westonb/wbraun_kicad_library/3D_Models/Transformer_POE13P.step

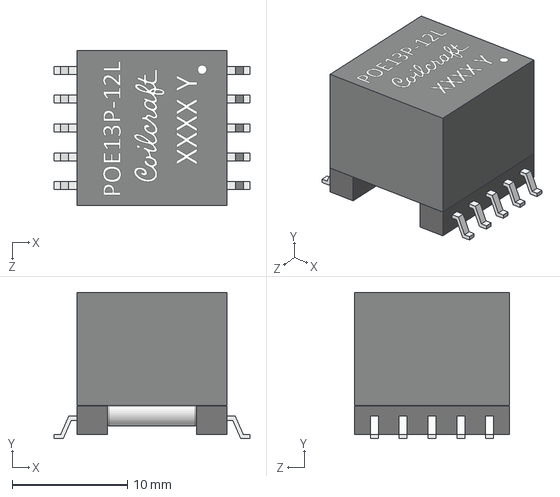
[picture p1: CAD file, 2026-11-03]
3D_Models/Transformer_POE13P.step
17.0 x 12.7 x 13.5 mm
