westonb/wbraun_kicad_library/3D_Models/C_Trimmer_GKG_6mm.step

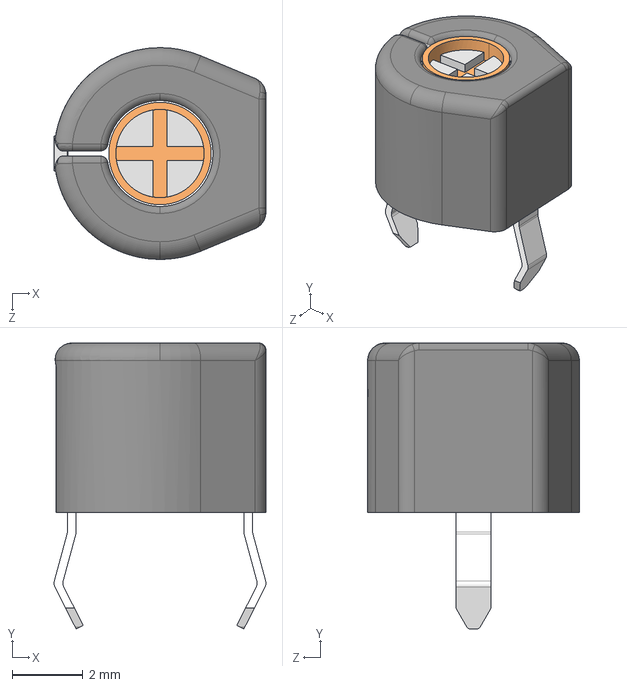
[picture p2: CAD file, 2026-11-03]
3D_Models/C_Trimmer_GKG_6mm.step
6.00 x 8.10 x 6.00 mm
