westonb/wbraun_kicad_library/3D_Models/SW_DPDT_x2_ALPS_SPUJ190900.stp

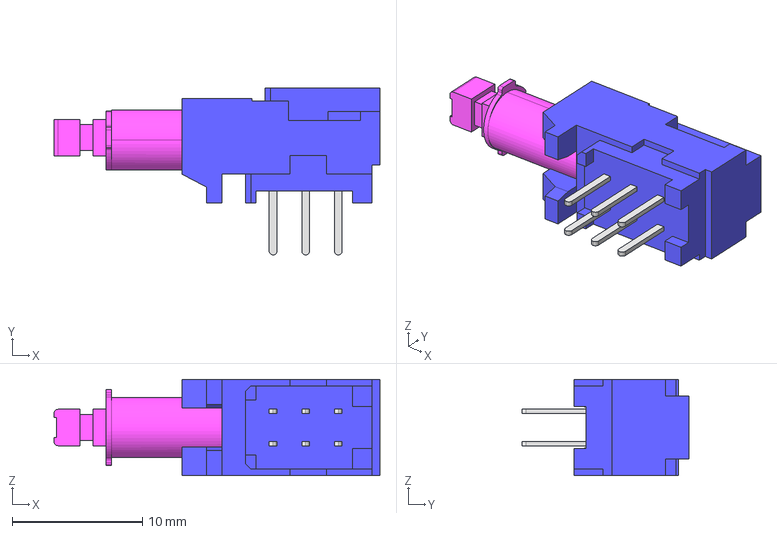
[picture p3: CAD file, 2026-11-03]
3D_Models/SW_DPDT_x2_ALPS_SPUJ190900.stp
25.0 x 12.8 x 7.40 mm
