westonb/wbraun_kicad_library/3D_Models/Converter_DCDC_1W_Isolated_Short.step

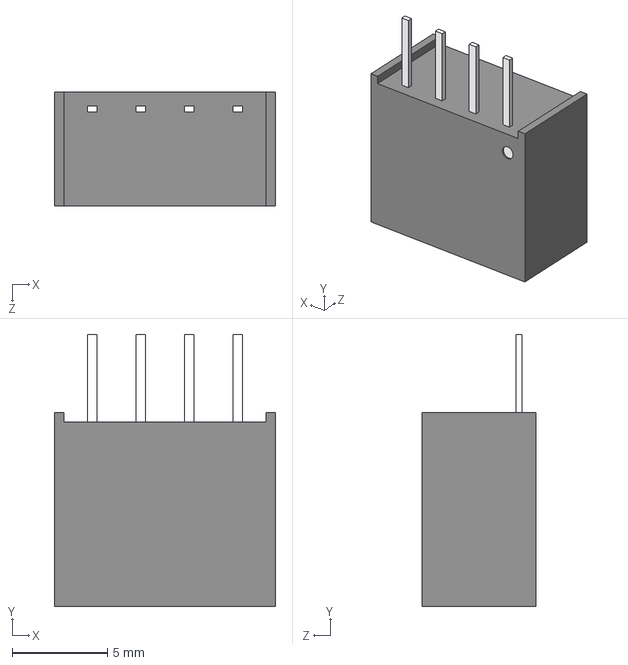
[picture p4: CAD file, 2026-11-03]
3D_Models/Converter_DCDC_1W_Isolated_Short.step
11.6 x 14.3 x 6.00 mm
