westonb/wbraun_kicad_library/3D_Models/EQ25-core.stp

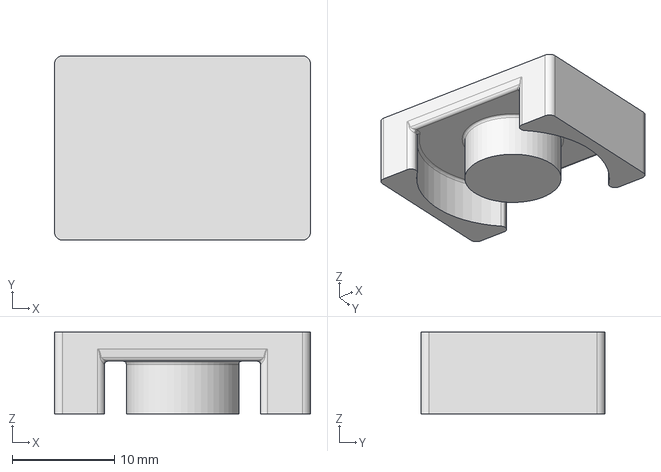
[picture p5: CAD file, 2026-11-03]
3D_Models/EQ25-core.stp
25.0 x 18.0 x 8.00 mm
