westonb/wbraun_kicad_library/3D_Models/SW_DIP_x04_CUI_DS02C-254-1L-04BE.step

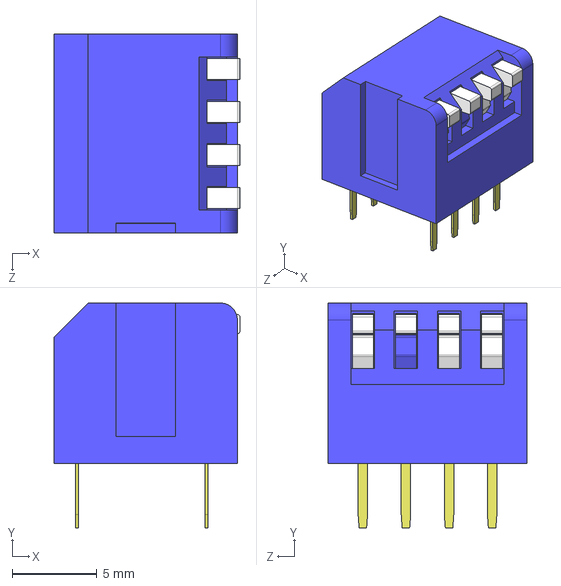
[picture p6: CAD file, 2026-11-03]
3D_Models/SW_DIP_x04_CUI_DS02C-254-1L-04BE.step
11.0 x 13.3 x 11.7 mm
