westonb/wbraun_kicad_library/3D_Models/TO-270WB-4.STEP

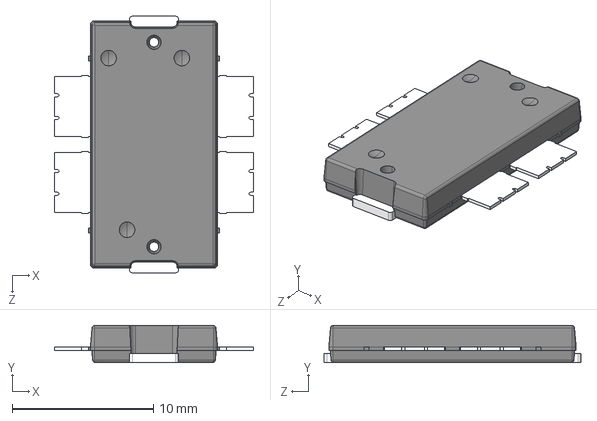
[picture p7: CAD file, 2026-11-03]
3D_Models/TO-270WB-4.STEP
14.1 x 2.64 x 18.2 mm
