westonb/wbraun_kicad_library/3D_Models/L_CommonModeChoke_Murata_DLW5BTM.STEP

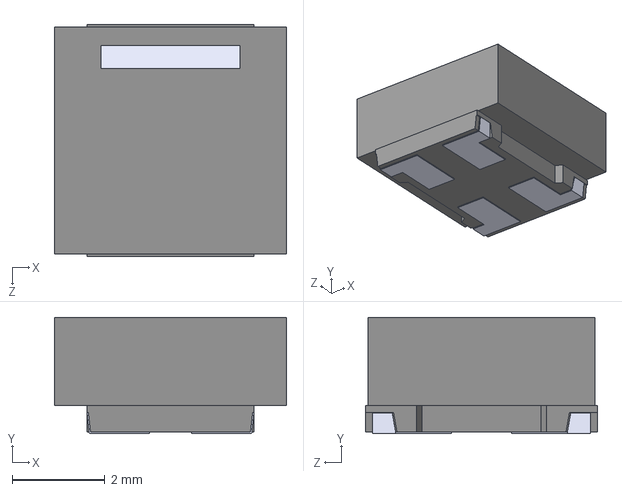
[picture p8: CAD file, 2022-10-10]
3D_Models/L_CommonModeChoke_Murata_DLW5BTM.STEP
5.00 x 2.50 x 5.00 mm
