westonb/wbraun_kicad_library/3D_Models/Coilcraft-1812SMS-27N.STEP

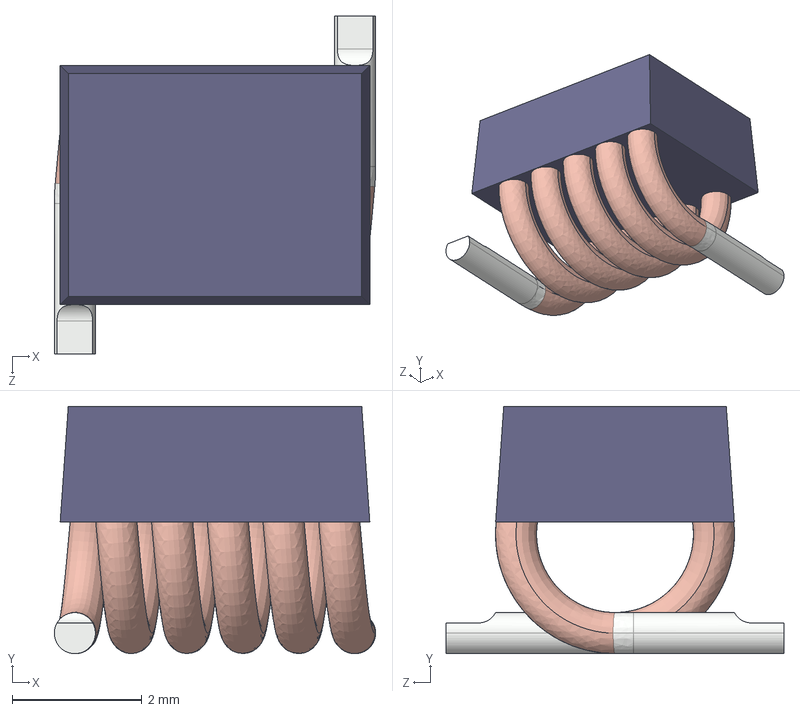
[picture p9: CAD file, 2022-10-10]
3D_Models/Coilcraft-1812SMS-27N.STEP
4.95 x 3.81 x 5.21 mm
Coilcraft-1812SMS-27N_W XXATZ2-X [1812SMS]_1812SMS-27N_2
Coilcraft-1812SMS-27N_36-625 [T7-566-1]_1812SMS-XXXL_2
