westonb/wbraun_kicad_library/3D_Models/GDT_1812.stp

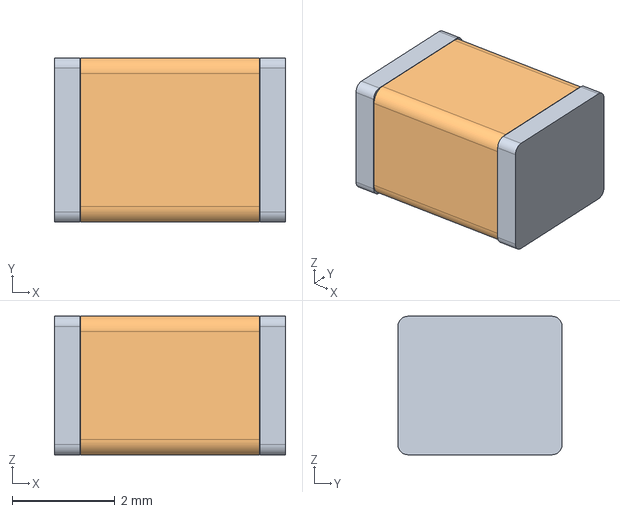
[picture p10: CAD file, 2022-10-10]
3D_Models/GDT_1812.stp
4.50 x 3.20 x 2.70 mm
