westonb/wbraun_kicad_library/3D_Models/LED-T1-RIGHT-ANGLE.STEP

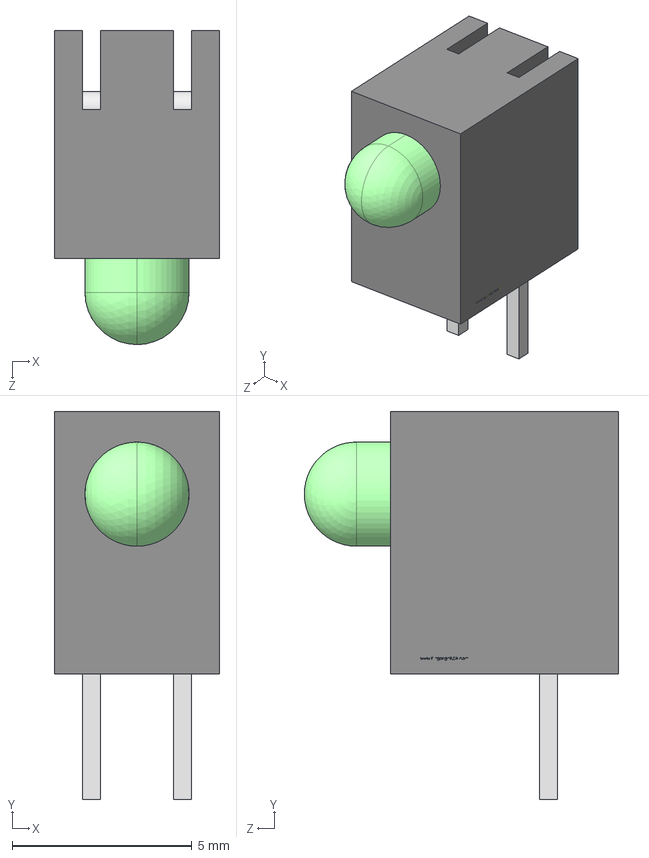
[picture p11: CAD file, 2022-10-10]
3D_Models/LED-T1-RIGHT-ANGLE.STEP
4.60 x 10.8 x 8.75 mm
