westonb/wbraun_kicad_library/3D_Models/Masach_Tech_MS288-10F.step

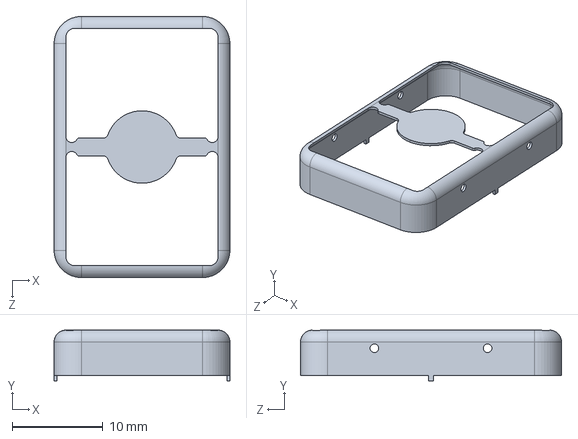
[picture p12: CAD file, 2022-10-10]
3D_Models/Masach_Tech_MS288-10F.step
19.4 x 5.60 x 28.8 mm
