westonb/wbraun_kicad_library/3D_Models/LED_WP934MD.STEP

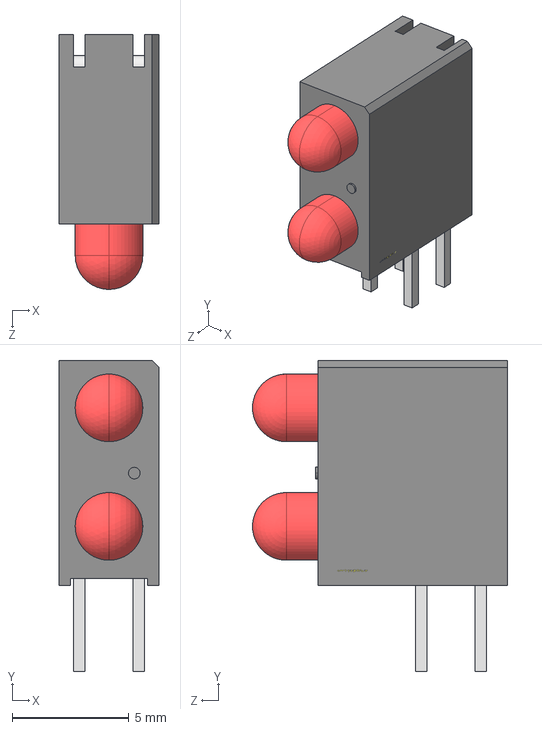
[picture p13: CAD file, 2022-10-10]
3D_Models/LED_WP934MD.STEP
4.30 x 13.3 x 10.9 mm
