westonb/wbraun_kicad_library/3D_Models/SMA_Molex_73251-2200.stp

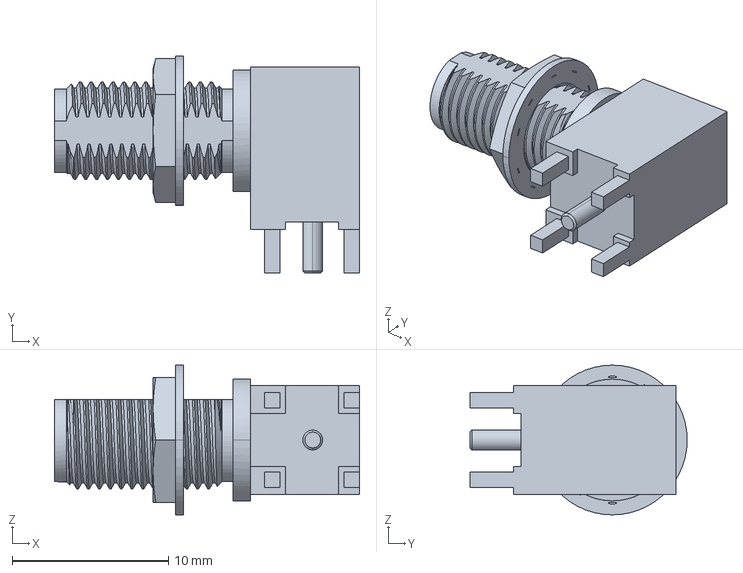
[picture p14: CAD file, 2022-10-10]
3D_Models/SMA_Molex_73251-2200.stp
19.5 x 13.9 x 9.60 mm
