westonb/wbraun_kicad_library/3D_Models/mill-max-0906-1-15-20-75-14-11-0.step

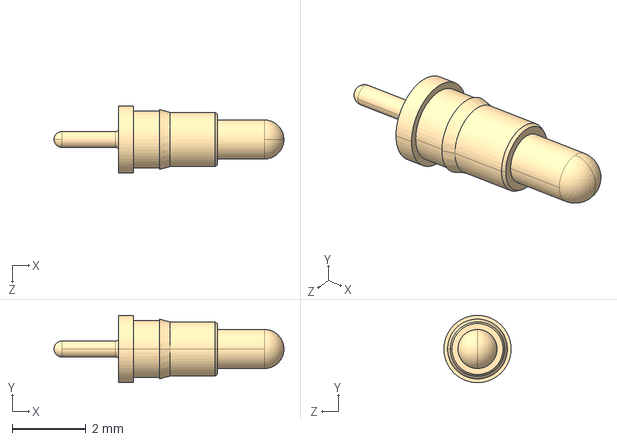
[picture p15: CAD file, 2022-10-10]
3D_Models/mill-max-0906-1-15-20-75-14-11-0.step
6.25 x 1.83 x 1.83 mm
