westonb/wbraun_kicad_library/3D_Models/D_POWERDI323.step

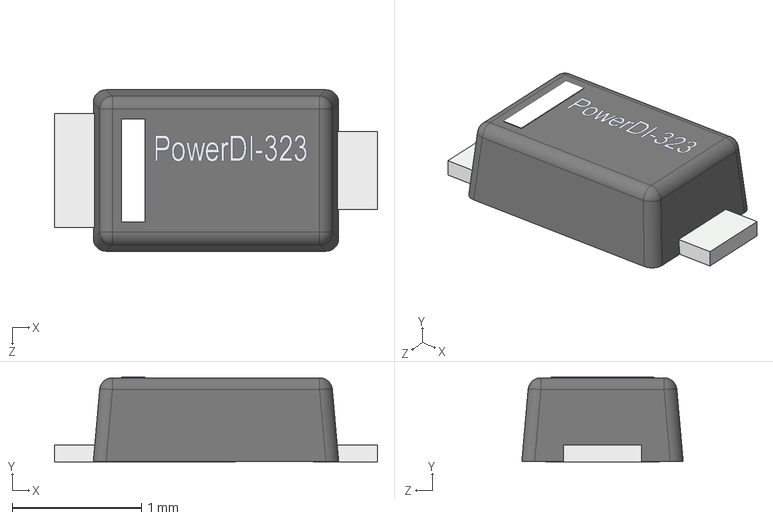
[picture p16: CAD file, 2022-10-10]
3D_Models/D_POWERDI323.step
2.50 x 0.656 x 1.25 mm
