westonb/wbraun_kicad_library/3D_Models/USB_B_OST_USB-B1HSxx_Horizontal.STEP

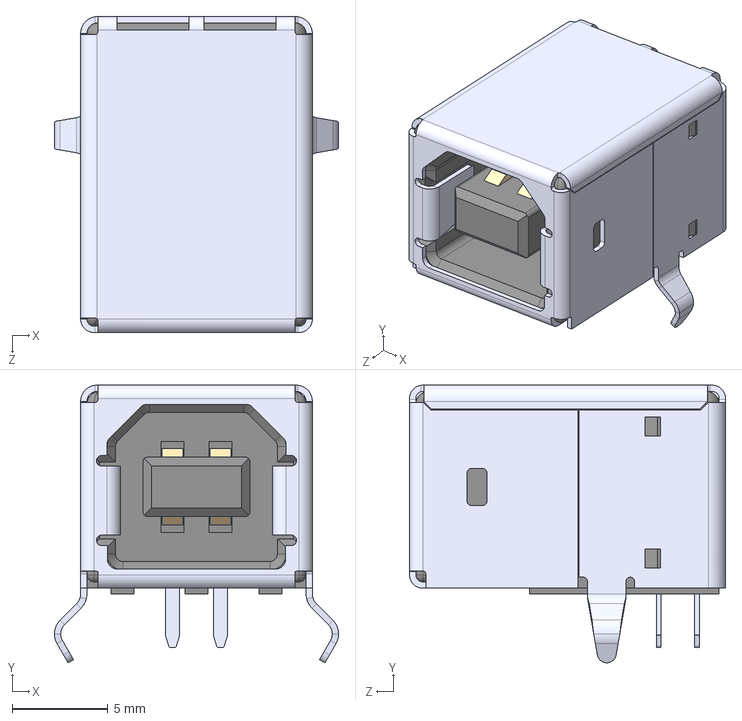
[picture p17: CAD file, 2022-10-10]
3D_Models/USB_B_OST_USB-B1HSxx_Horizontal.STEP
14.8 x 14.5 x 16.5 mm
