westonb/wbraun_kicad_library/3D_Models/CUI_DEVICES_DS01C-254-S-08BE.step

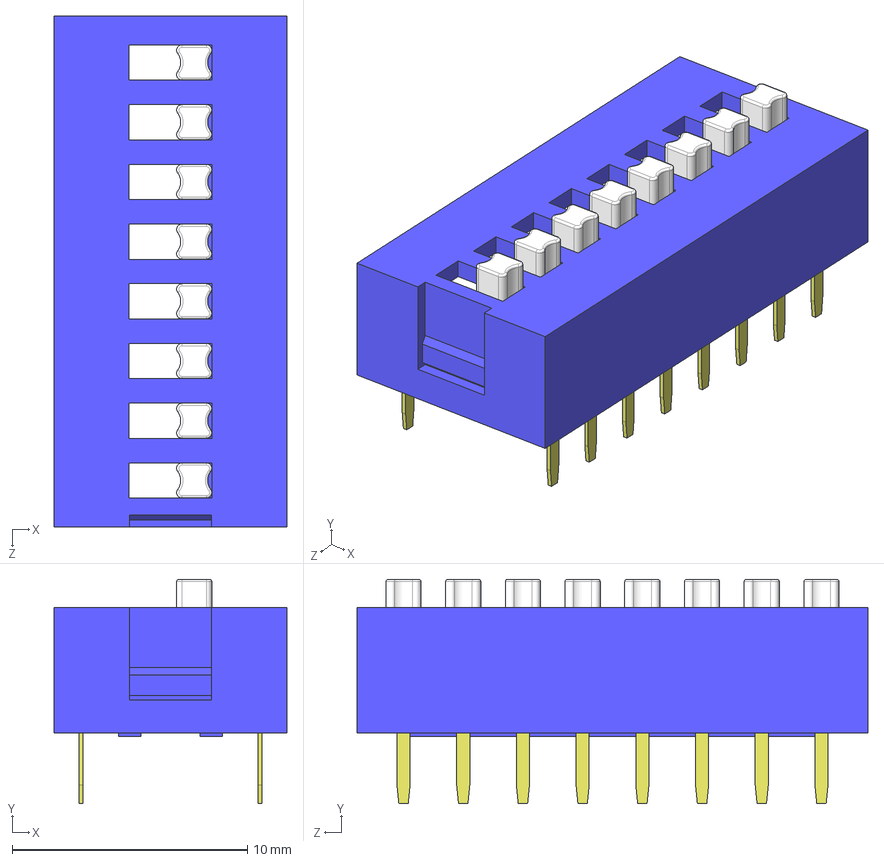
[picture p18: CAD file, 2021-12-18]
3D_Models/CUI_DEVICES_DS01C-254-S-08BE.step
9.90 x 9.55 x 21.7 mm
