westonb/wbraun_kicad_library/3D_Models/PTS810 SJK 250 SMTR LFS--3DModel-STEP-1.STEP

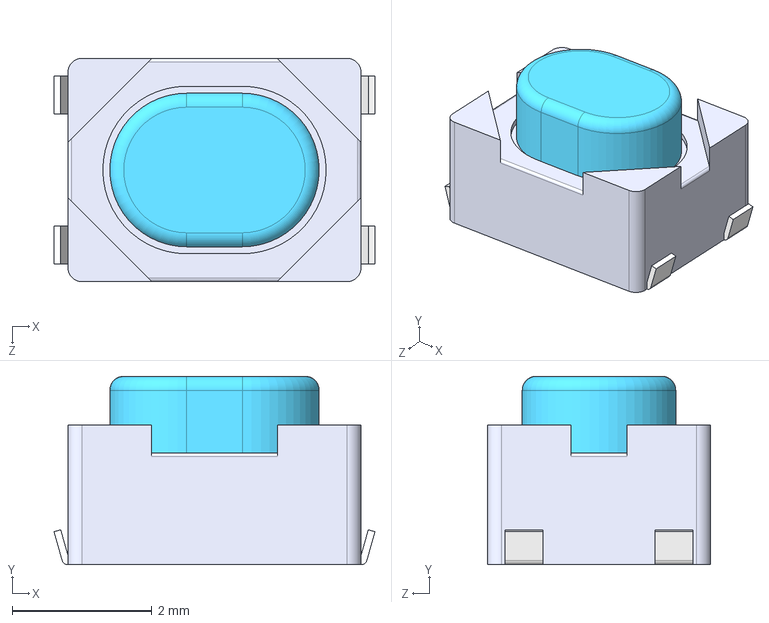
[picture p19: CAD file, 2021-12-18]
3D_Models/PTS810 SJK 250 SMTR LFS--3DModel-STEP-1.STEP
4.60 x 2.70 x 3.20 mm
