westonb/wbraun_kicad_library/3D_Models/SMA-J-P-H-ST-EM1--3DModel-STEP-46669.STEP

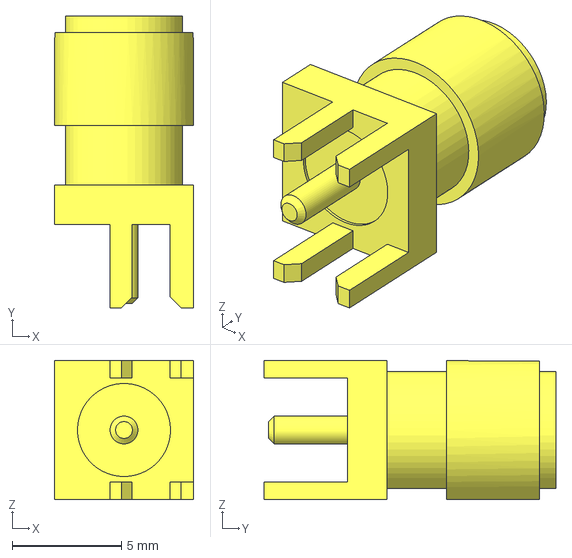
[picture p20: CAD file, 2021-12-18]
3D_Models/SMA-J-P-H-ST-EM1--3DModel-STEP-46669.STEP
6.35 x 13.3 x 6.35 mm
