westonb/wbraun_kicad_library/3D_Models/EPC_-_EPC2038.step

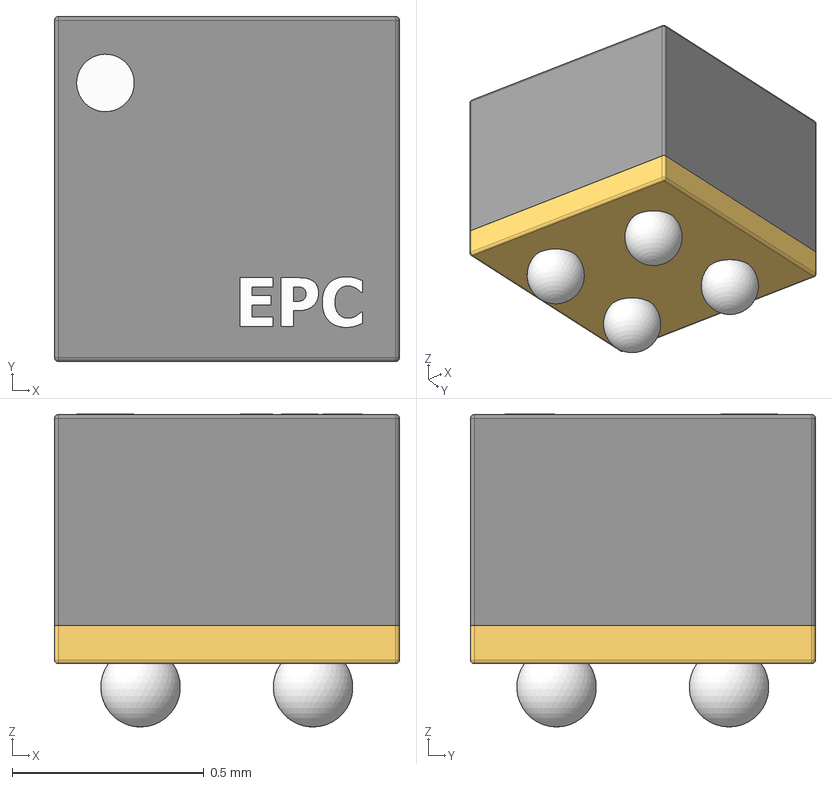
[picture p21: CAD file, 2021-12-01]
3D_Models/EPC_-_EPC2038.step
0.9 x 0.9 x 0.816 mm
BGA_body
BGA_Ball x 4
circle
top
EPC
