westonb/wbraun_kicad_library/3D_Models/Coilcraft-CST2010.step

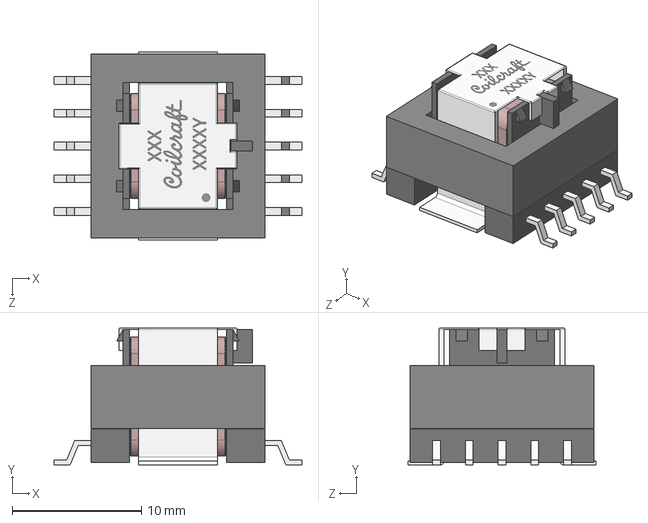
[picture p22: CAD file, 2021-12-01]
3D_Models/Coilcraft-CST2010.step
19.2 x 10.6 x 14.6 mm
