westonb/wbraun_kicad_library/3D_Models/Coilcraft-SER2918H.step

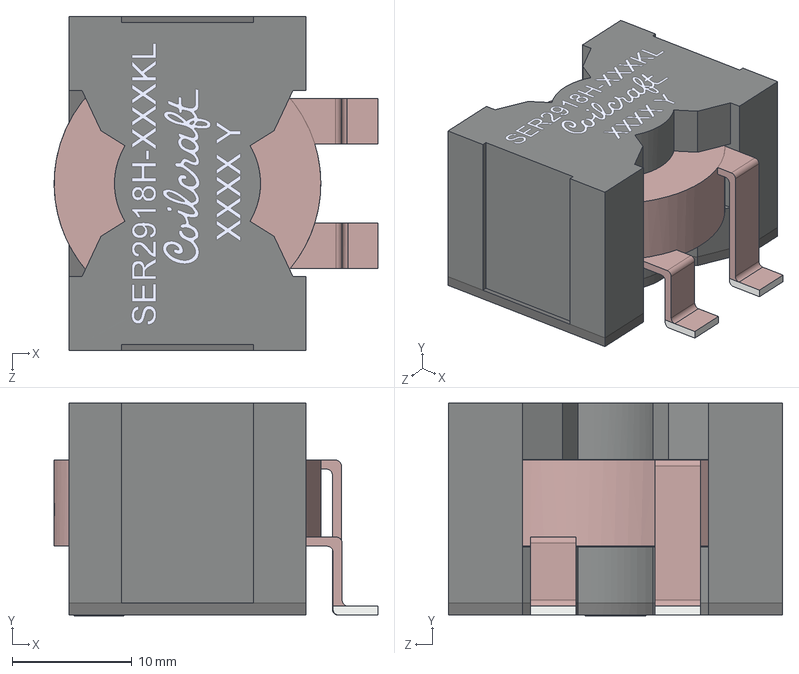
[picture p23: CAD file, 2021-12-01]
3D_Models/Coilcraft-SER2918H.step
27.0 x 17.8 x 27.9 mm
