westonb/wbraun_kicad_library/3D_Models/FH12-20S-0.5SH.stp

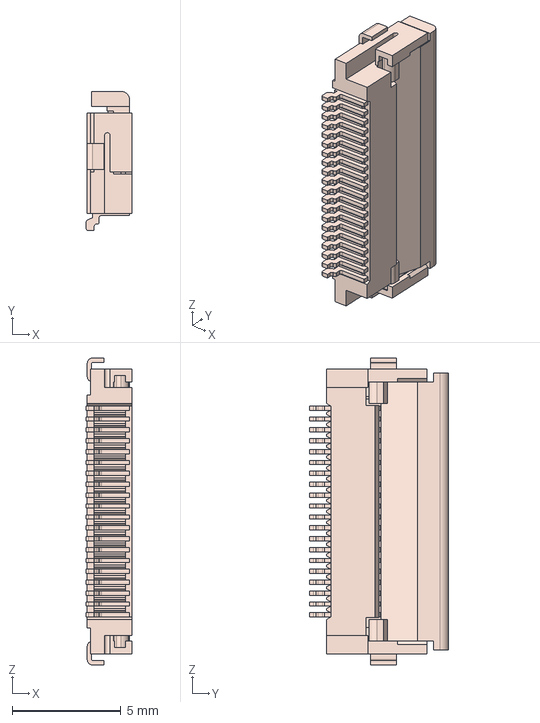
[picture p24: CAD file, 2021-12-01]
3D_Models/FH12-20S-0.5SH.stp
2.10 x 6.40 x 14.1 mm
