westonb/wbraun_kicad_library/3D_Models/Fuse_3912.STEP

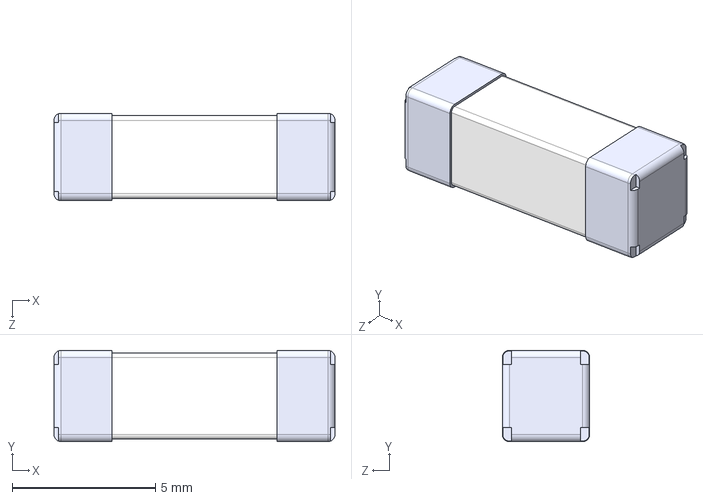
[picture p25: CAD file, 2021-12-01]
3D_Models/Fuse_3912.STEP
9.80 x 3.18 x 3.05 mm
