westonb/wbraun_kicad_library/3D_Models/Texas_Instruments_-_LMG1210RVRT.step

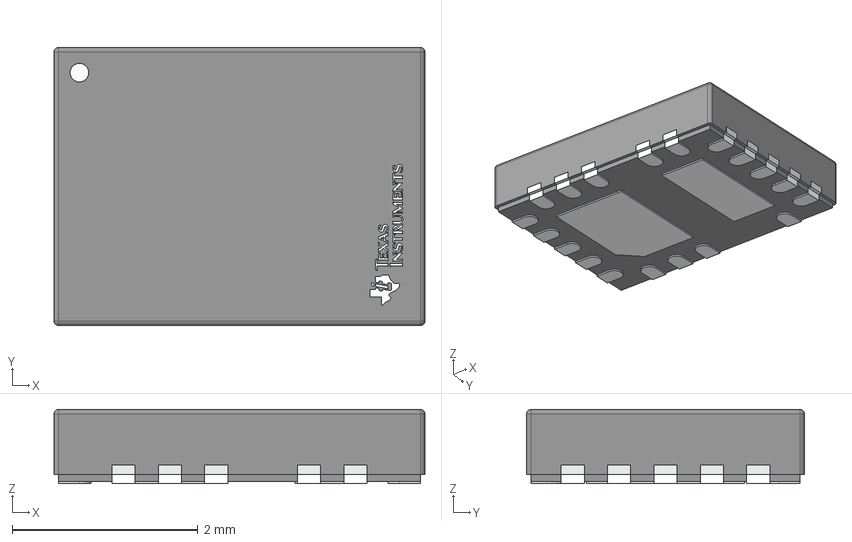
[picture p26: CAD file, 2021-12-01]
3D_Models/Texas_Instruments_-_LMG1210RVRT.step
4.00 x 3.00 x 0.801 mm
BODY-QFN_AF0
FRAME-RVR0019A_AF0
Pin1_Dot
Texas Instruments
