westonb/wbraun_kicad_library/3D_Models/D0221.step

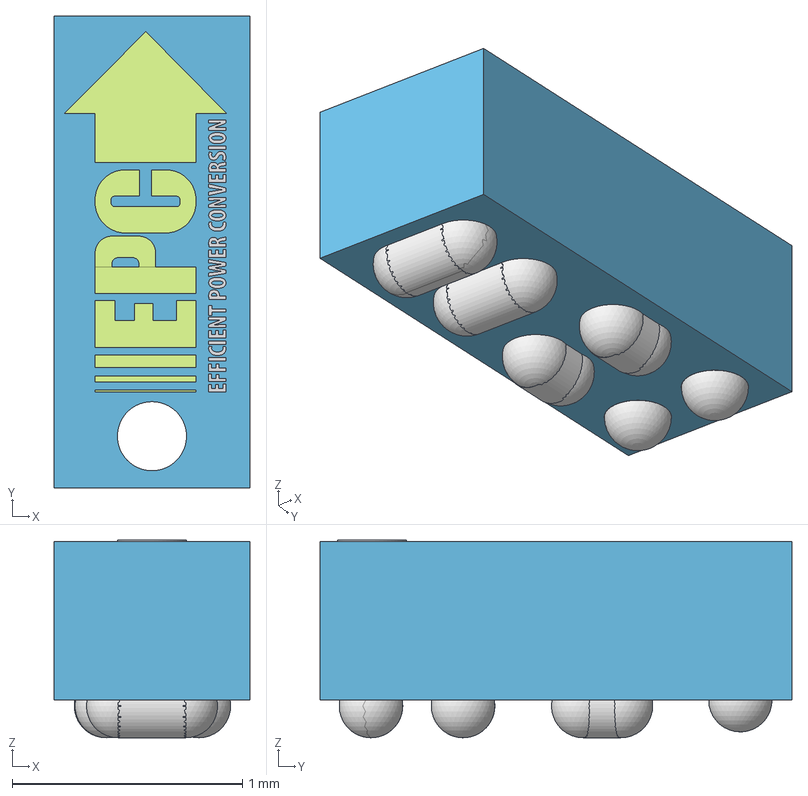
[picture p27: CAD file, 2021-12-01]
3D_Models/D0221.step
0.85 x 2.05 x 0.858 mm
Board
3D_EPClogo1_5mm
3D_EPClogo1_5mm001
Extruded
