westonb/wbraun_kicad_library/3D_Models/Analog_Devices_-_ADP7112ACBZ-3.3-R7.step

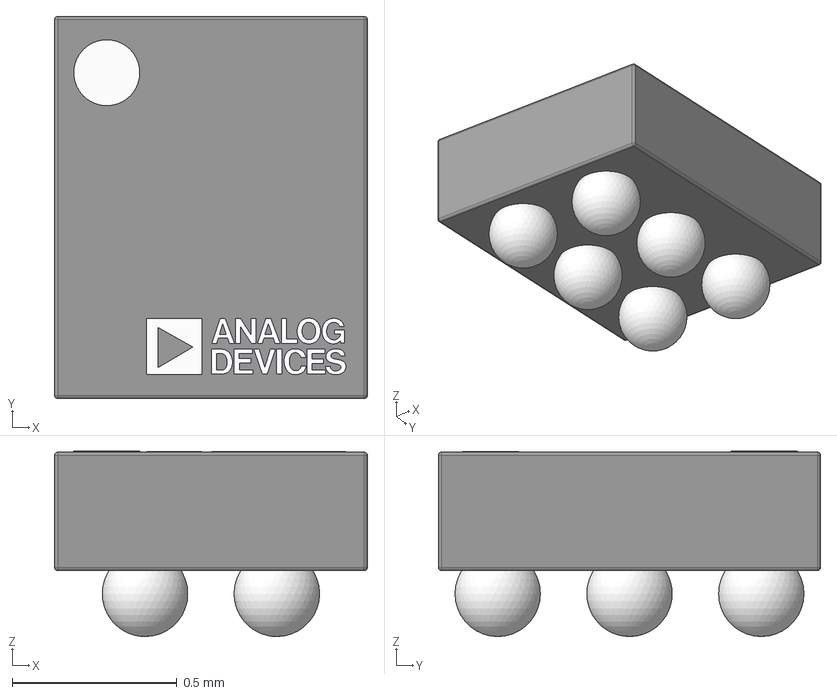
[picture p28: CAD file, 2021-12-01]
3D_Models/Analog_Devices_-_ADP7112ACBZ-3.3-R7.step
0.95 x 1.16 x 0.562 mm
BGA_body
circle
Analog Devices
balls
