westonb/wbraun_kicad_library/3D_Models/FDD1.25-312.step

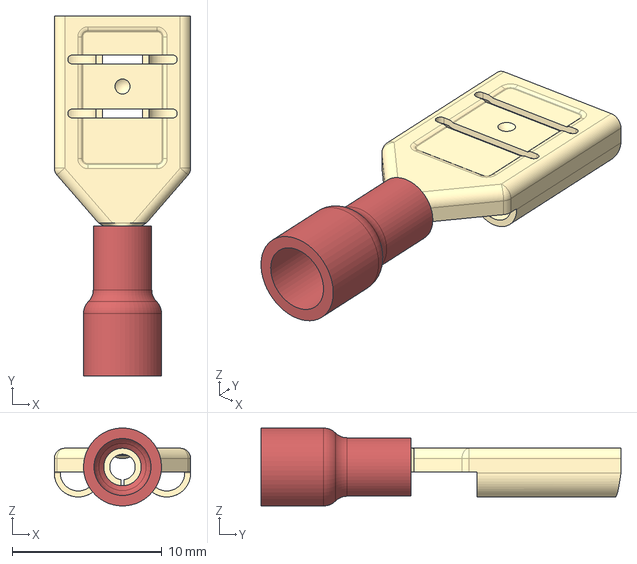
[picture p29: CAD file, 2021-08-21]
3D_Models/FDD1.25-312.step
9.10 x 24.0 x 5.20 mm
