westonb/wbraun_kicad_library/3D_Models/mini-circuits-CD637.step

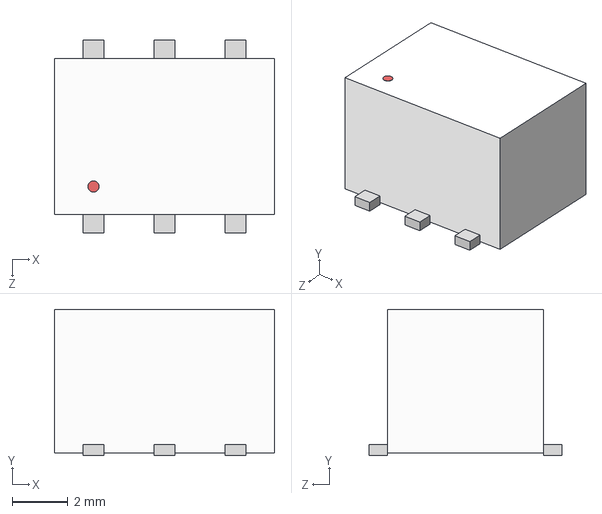
[picture p30: CAD file, 2021-08-21]
3D_Models/mini-circuits-CD637.step
7.87 x 5.24 x 6.91 mm
