westonb/wbraun_kicad_library/3D_Models/pm1812.stp

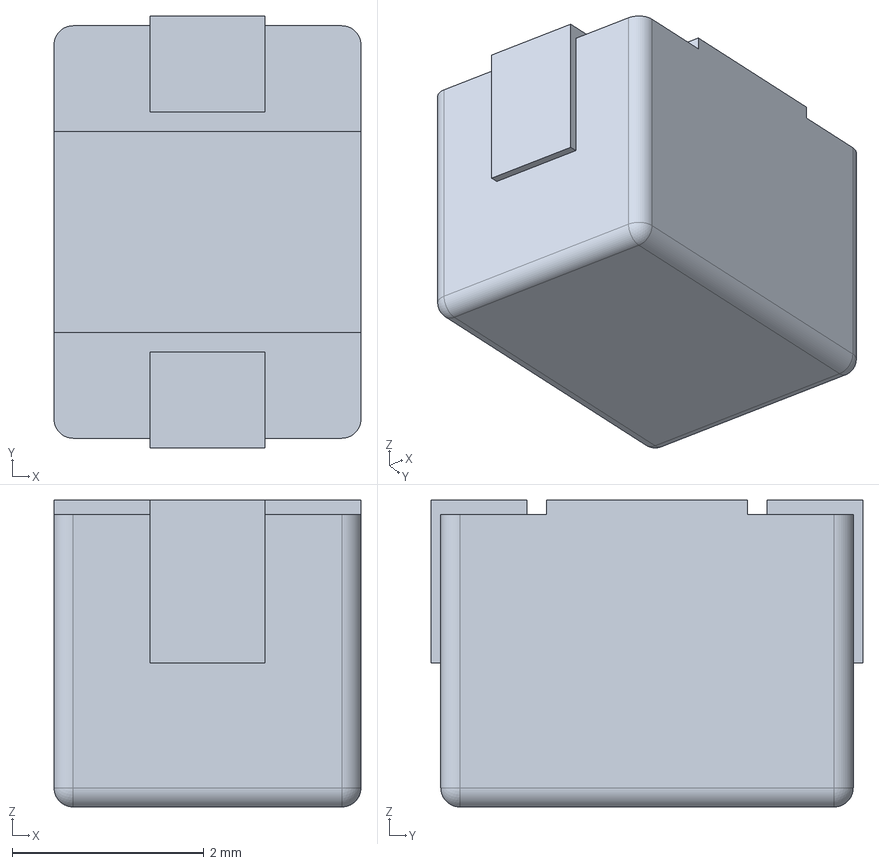
[picture p31: CAD file, 2021-08-09]
3D_Models/pm1812.stp
3.20 x 4.50 x 3.20 mm
