westonb/wbraun_kicad_library/3D_Models/WE-HCC-1090.stp

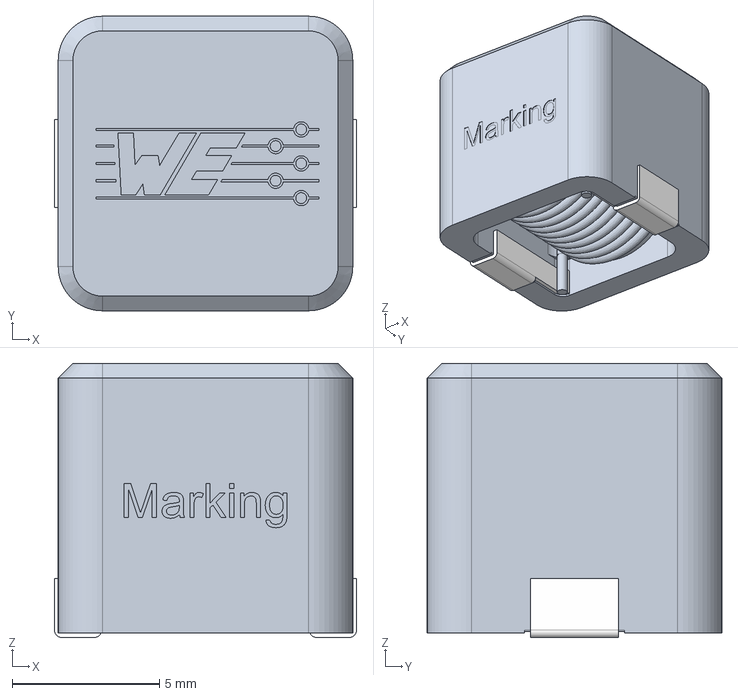
[picture p32: CAD file, 2021-08-09]
3D_Models/WE-HCC-1090.stp
10.2 x 10.0 x 9.30 mm
