westonb/wbraun_kicad_library/3D_Models/2045-xx-xx.stp

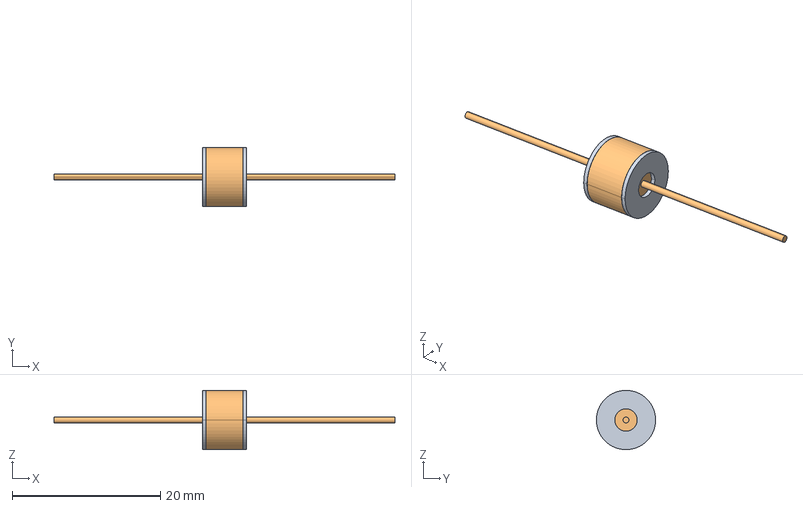
[picture p33: CAD file, 2021-08-09]
3D_Models/2045-xx-xx.stp
46.0 x 8.00 x 8.00 mm
