westonb/wbraun_kicad_library/3D_Models/1206_PTC_FUSE.STEP

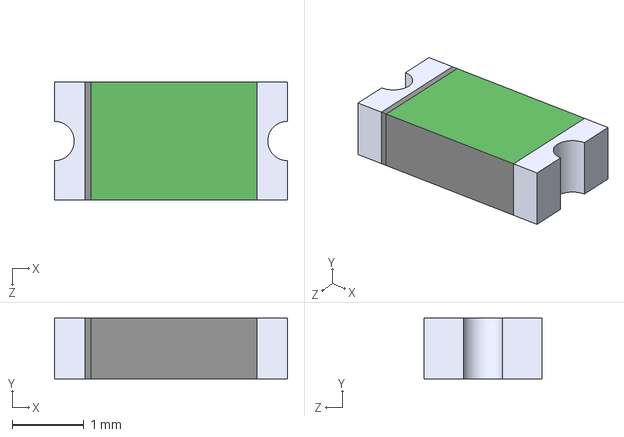
[picture p34: CAD file, 2020-11-21]
3D_Models/1206_PTC_FUSE.STEP
3.25 x 0.85 x 1.65 mm
