westonb/wbraun_kicad_library/3D_Models/TRIMMER_PVG3A.STEP

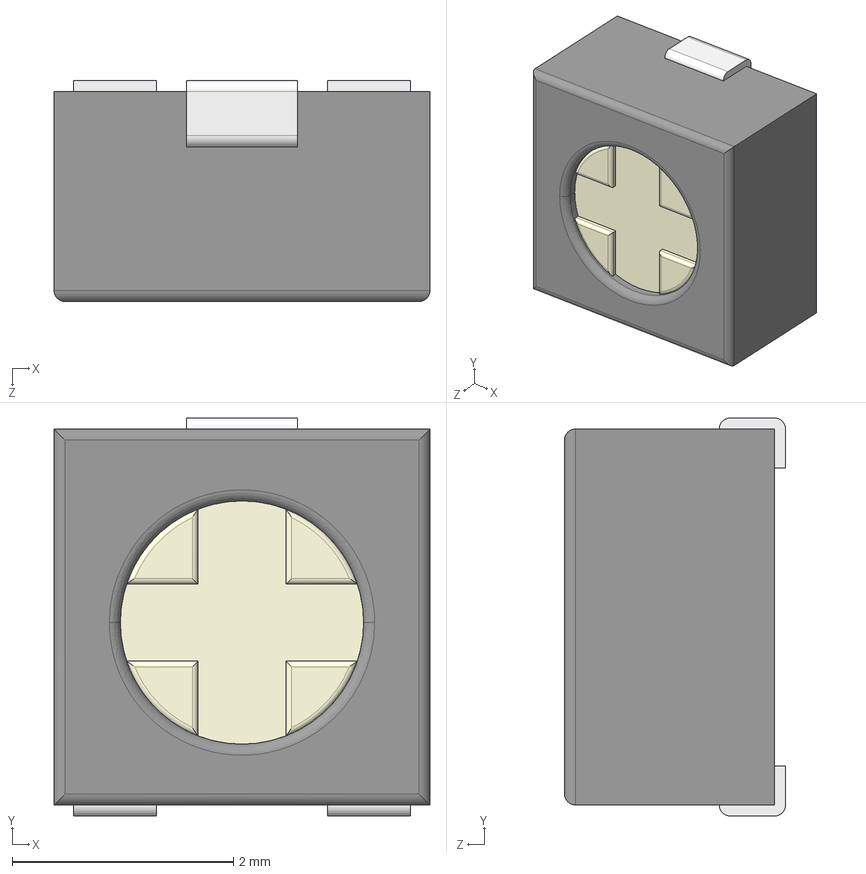
[picture p35: CAD file, 2020-11-21]
3D_Models/TRIMMER_PVG3A.STEP
3.40 x 3.60 x 2.00 mm
ACIS Solid_3223
ACIS Solid_3378
ACIS Solid_3314
ACIS Solid_3586
ACIS Solid_3259
