westonb/wbraun_kicad_library/3D_Models/BCAAPC--3DModel-STEP-56544.STEP

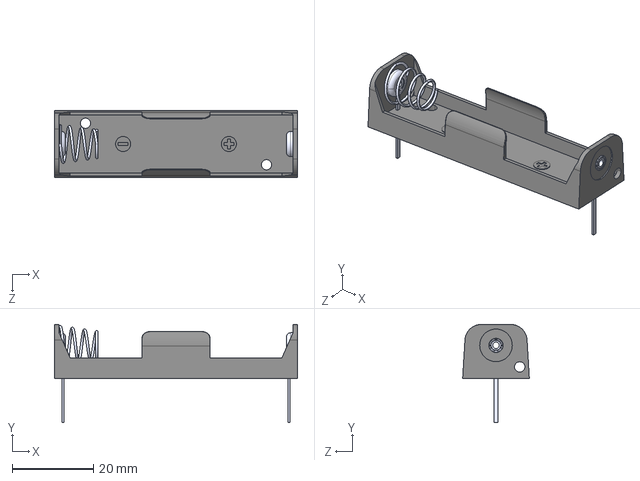
[picture p36: CAD file, 2020-11-21]
3D_Models/BCAAPC--3DModel-STEP-56544.STEP
59.7 x 24.1 x 16.4 mm
