westonb/wbraun_kicad_library/3D_Models/KEYSTONE 2460.step

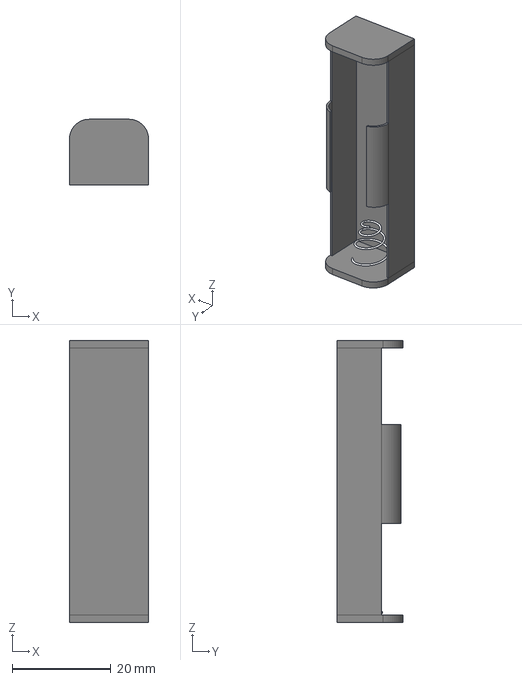
[picture p37: CAD file, 2020-11-21]
3D_Models/KEYSTONE 2460.step
16.0 x 13.3 x 57.0 mm
