westonb/wbraun_kicad_library/3D_Models/Keystone_7693.STEP

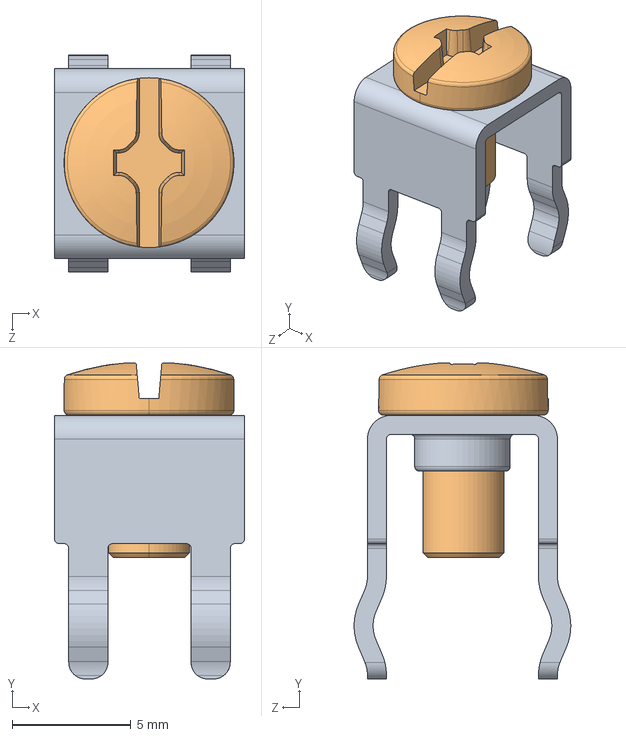
[picture p38: CAD file, 2020-11-21]
3D_Models/Keystone_7693.STEP
8.00 x 13.3 x 9.12 mm
Keystone_7691
6-32-panhead_6mm_thd
