westonb/wbraun_kicad_library/3D_Models/c-619540-1-a-3d.stp

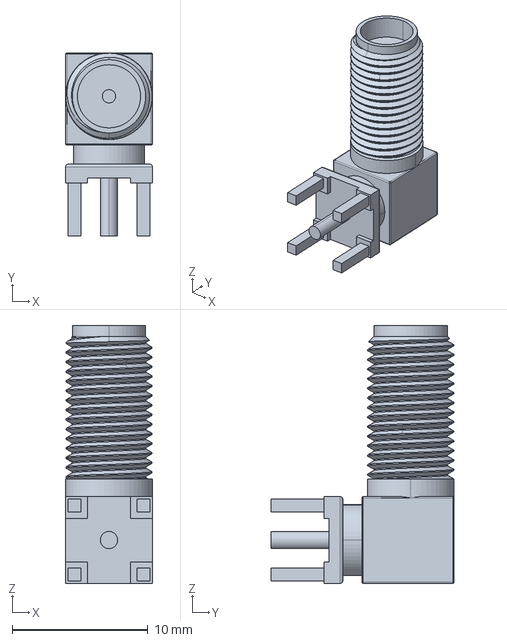
[picture p39: CAD file, 2020-08-13]
3D_Models/c-619540-1-a-3d.stp
6.40 x 13.5 x 19.0 mm
