westonb/wbraun_kicad_library/3D_Models/BHAA-POL-G.STEP

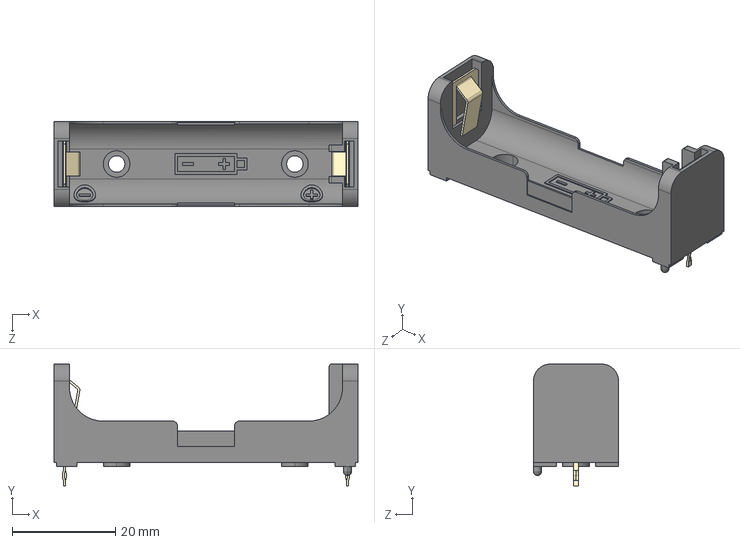
[picture p40: CAD file, 2020-08-13]
3D_Models/BHAA-POL-G.STEP
58.9 x 23.6 x 16.5 mm
