westonb/wbraun_kicad_library/3D_Models/142-0701-301.stp

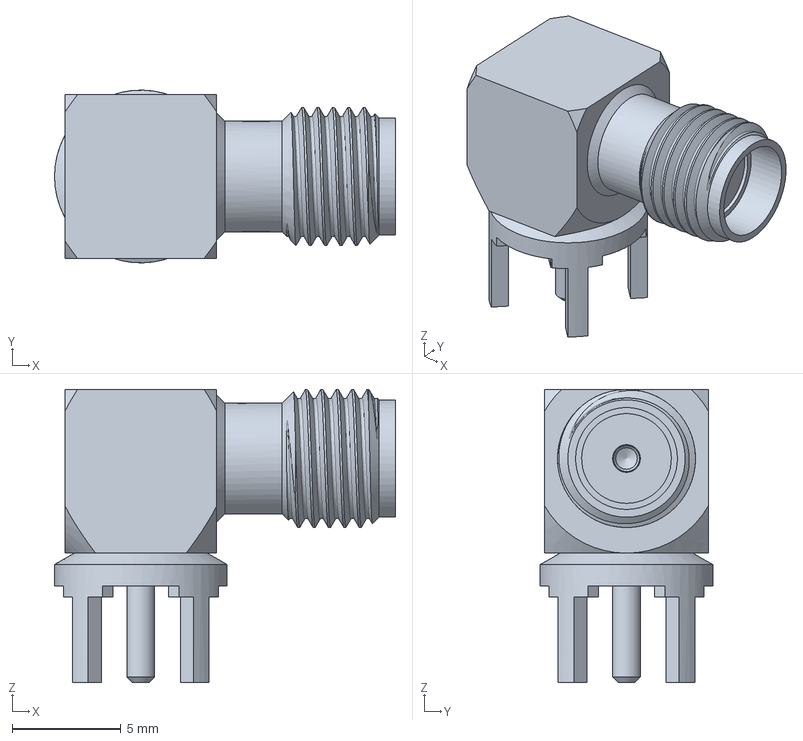
[picture p41: CAD file, 2020-08-13]
3D_Models/142-0701-301.stp
15.6 x 7.92 x 13.5 mm
