westonb/wbraun_kicad_library/3D_Models/EG1247.stp

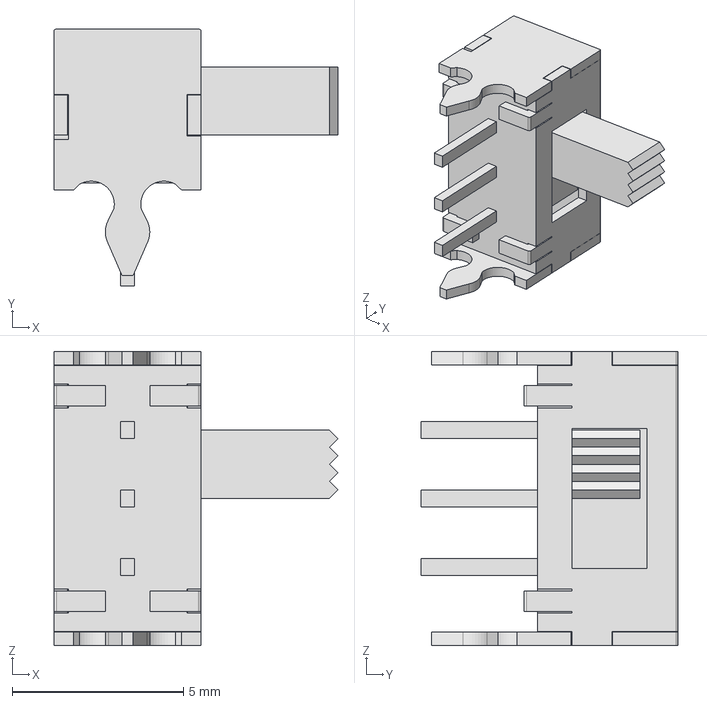
[picture p42: CAD file, 2020-08-13]
3D_Models/EG1247.stp
8.30 x 7.50 x 8.60 mm
