westonb/wbraun_kicad_library/3D_Models/BH9VPC.STEP

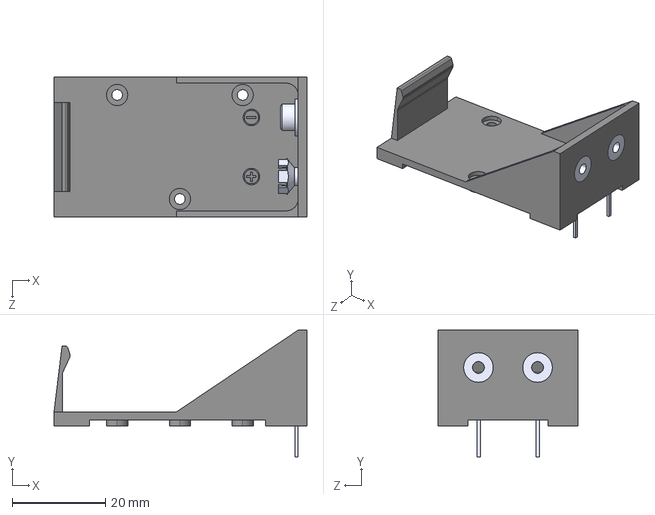
[picture p43: CAD file, 2020-08-13]
3D_Models/BH9VPC.STEP
54.4 x 27.2 x 30.0 mm
