westonb/wbraun_kicad_library/3D_Models/SunLED_-_XZMDKCBDDG45S-9.step

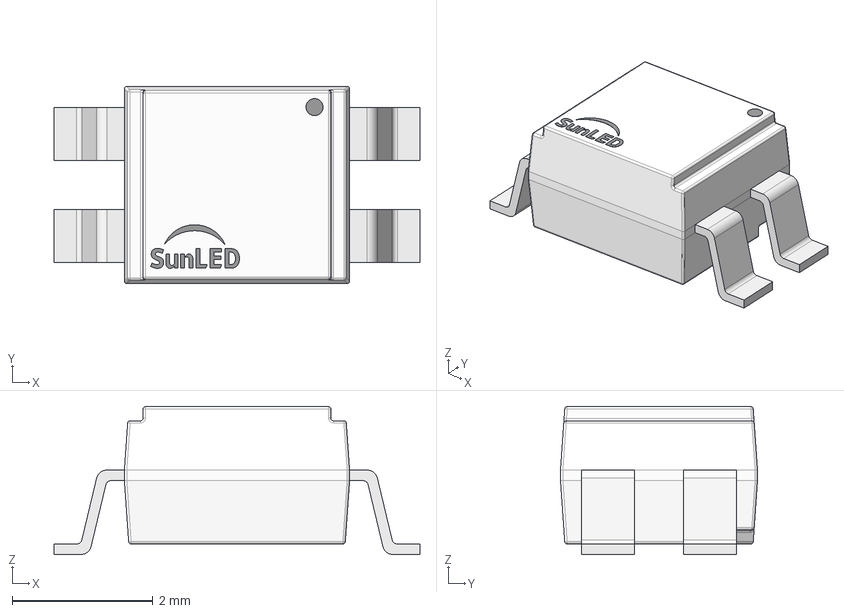
[picture p44: CAD file, 2020-08-13]
3D_Models/SunLED_-_XZMDKCBDDG45S-9.step
5.20 x 2.80 x 2.10 mm
terminals
marking
top
led red
led green
led blue
