westonb/wbraun_kicad_library/3D_Models/VLCF4020.step

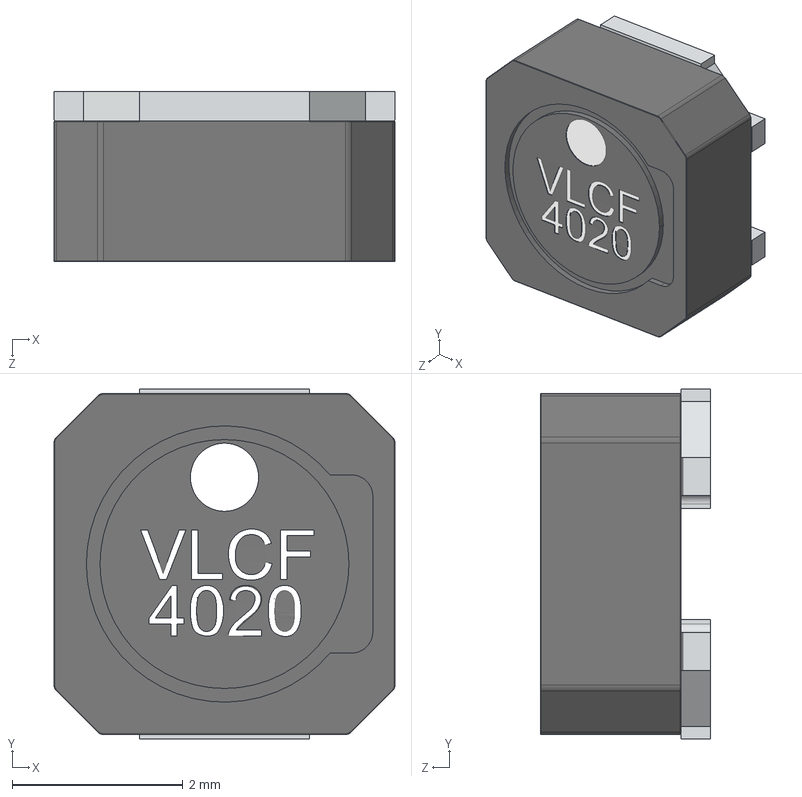
[picture p45: CAD file, 2020-08-13]
3D_Models/VLCF4020.step
4.00 x 4.10 x 2.00 mm
