westonb/wbraun_kicad_library/3D_Models/HMC1041Z.step

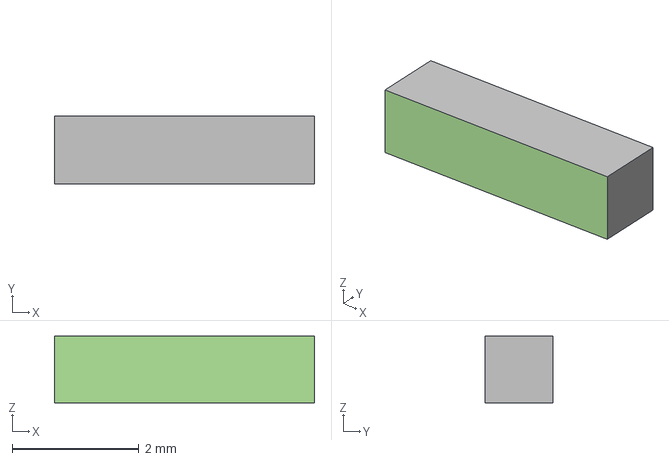
[picture p46: CAD file, 2020-06-24]
3D_Models/HMC1041Z.step
4.10 x 1.08 x 1.05 mm
