westonb/wbraun_kicad_library/3D_Models/Coilcraft-MSS1583.step

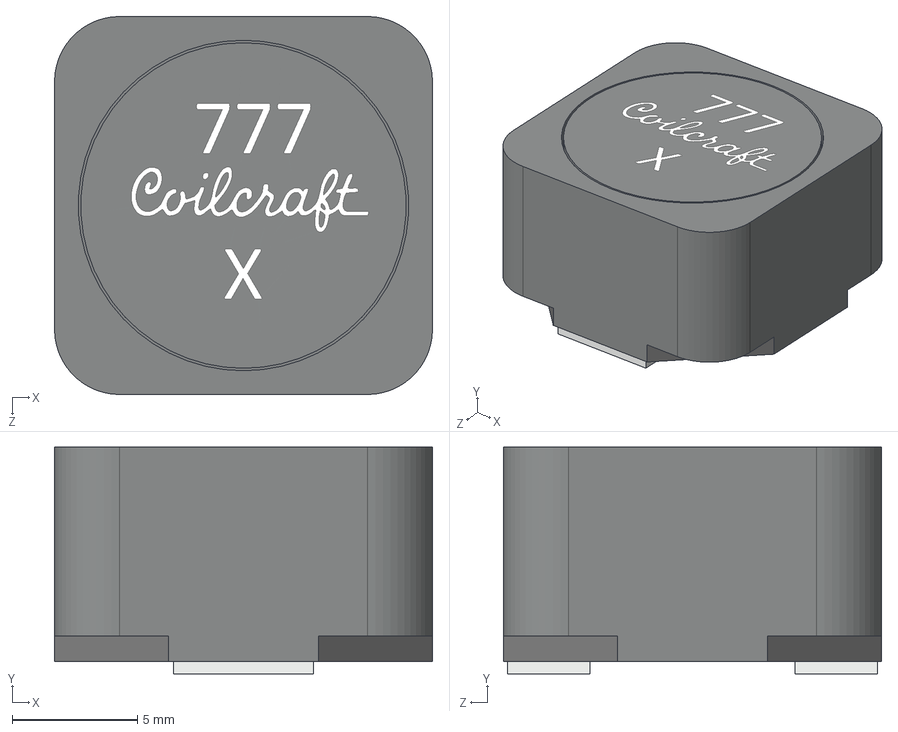
[picture p47: CAD file, 2020-06-24]
3D_Models/Coilcraft-MSS1583.step
15.1 x 9.05 x 15.1 mm
