westonb/wbraun_kicad_library/3D_Models/Coilcraft-XGL6060.step

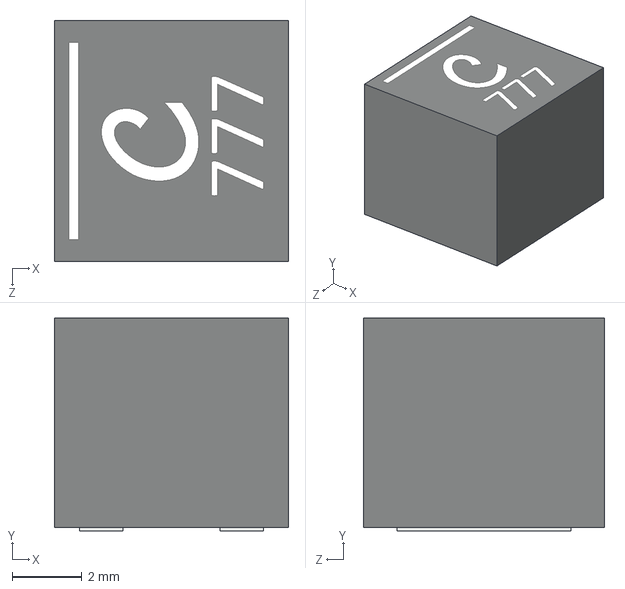
[picture p48: CAD file, 2020-06-24]
3D_Models/Coilcraft-XGL6060.step
6.71 x 6.10 x 6.91 mm
