westonb/wbraun_kicad_library/(list of files, cad)

Other CAD files:
3D_Models/395021002.stp
3D_Models/395021004.stp
3D_Models/395021006.stp
3D_Models/5003340160.stp
3D_Models/541020164.stp
3D_Models/62409-1.stp
3D_Models/744777910_Download_WE-PD_7345R_STP_rev1.stp
3D_Models/OS102011MA1QN1.stp
