westonb/wbraun_kicad_library/(commit log)

2015-02-06 fixed SMD button, added new SMD footprints
2015-10-13 added lots of voltage regulators and artix-7 in FBGA-484
2015-12-03 fixed issues with interchangable sections on artix-7 schematic symbol
2015-12-04 added lots of new footprints
2015-12-05 fixed error in PCB schematic symbol
2015-12-28 fixed error in artix-7 schematic symbol, pcie footprint, and QFN-40 footprint
2016-01-21 added footprints for SMD relay and 3.5mm terminal block
2016-01-31 fixed missing power symbol on XC7Axxt-FGG484
2016-02-02 added SMD relays
2016-02-02 added breakout boards
2016-02-05 fixed duplicate pin on XCAxxt-FGG484
2016-09-06 added new audio jack and inductor footprint
2017-02-08 GaN Footprints
2017-10-19 added new gate drivers, isolated power supply schematic symbol / footprint
2017-10-26 added inductors and type N connector
2017-11-07 added testpoint footprint
2017-11-17 added B.Mask squares for kicad bug
2017-11-21 fixed invalid characters in schematic symbol name
2018-11-12 added spartan7 schematic symbol
2018-11-13 added new SPI flash
2018-11-26 new connector footprints
2018-11-27 more footprints
2019-01-09 added inductor footprint
2019-01-18 added ADC schematic symbol
2019-03-25 added power components
2019-10-30 new inductor footprints
2020-02-19 added new power components
2020-06-24 added more footprints
    [395021006.stp, 5003340160.stp, 541020164.stp, Coilcraft-MSS1583.step, Coilcraft-XGL6060.step, EPC2214.step, HMC1041Z.step, OS102011MA1QN1.stp]
2020-08-13 your irregularly regularly scheduled component addition
    [142-0701-301.stp, BH9VPC.STEP, BHAA-POL-G.STEP, EG1247.stp, SunLED_-_XZMDKCBDDG45S-9.step, VLCF4020.step, c-619540-1-a-3d.stp]
2020-11-21 added more inductors
    [1206_PTC_FUSE.STEP, BCAAPC--3DModel-STEP-56544.STEP, KEYSTONE 2460.step, Keystone_7693.STEP, TRIMMER_PVG3A.STEP]
2021-08-09 inductor models
    [2045-xx-xx.stp, 62409-1.stp, WE-HCC-1090.stp, pm1812.stp]
2021-08-21 LISN project footprints
    [FDD1.25-312.step, mini-circuits-CD637.step]
2021-12-01 regular footprint update
    [395021002.stp, Analog_Devices_-_ADP7112ACBZ-3.3-R7.step, Coilcraft-CST2010.step, Coilcraft-SER2918H.step, D0221.step, EPC_-_EPC2038.step, FH12-20S-0.5SH.stp, Fuse_3912.STEP]
2021-12-18 regular component addition
    [395021004.stp, 744777910_Download_WE-PD_7345R_STP_rev1.stp, CUI_DEVICES_DS01C-254-S-08BE.step, PTS810 SJK 250 SMTR LFS--3DModel-STEP-1.STEP, SMA-J-P-H-ST-EM1--3DModel-STEP-46669.STEP]
2022-10-10 library updates
    [Coilcraft-1812SMS-27N.STEP, D_POWERDI323.step, GDT_1812.stp, LED-T1-RIGHT-ANGLE.STEP, LED_WP934MD.STEP, L_CommonModeChoke_Murata_DLW5BTM.STEP, Masach_Tech_MS288-10F.step, SMA_Molex_73251-2200.stp]
